chris1seto/OzarkPinnacle/Embedded/OzarkPinnacle/Src/Nmea0183.h

#ifndef NMEA_H
#define NMEA_H

#include <stdint.h>
#include <stm32f4xx_hal.h>
#include "FreeRTOS.h"
#include "task.h"
#include "queue.h"

typedef struct
{
  uint8_t hour;
  uint8_t minute;
  float second;
} NmeaTime_t;

typedef struct
{
  uint8_t day;
  uint8_t month;
  uint8_t year;
} NmeaDate_t;

typedef struct
{
  float lat;
  float lon;
} NmeaPosition_t;

typedef struct
{
  NmeaTime_t time;
  NmeaPosition_t position;
  uint8_t fix;
  int32_t sat_count;
  float h_dop;
  float altitude;
  uint8_t altitude_units;
} NmeaGga_t;

typedef struct
{
  NmeaTime_t time;
  uint8_t fix;
  NmeaPosition_t position;
  float speed;
  float track;
  NmeaDate_t date;
} NmeaRmc_t;

typedef struct
{
  NmeaTime_t time;
  uint8_t day;
  uint8_t month;
  uint32_t year;
  uint8_t valid;
} NmeaZda_t;

enum NMEA_MESSAGE_TYPE
{
  NMEA_MESSAGE_TYPE_GGA,
  NMEA_MESSAGE_TYPE_RMC,
  NMEA_MESSAGE_TYPE_GSA,
  NMEA_MESSAGE_TYPE_ZDA
};

typedef struct
{
  enum NMEA_MESSAGE_TYPE message_type;
  union
  {
    NmeaGga_t gga;
    NmeaRmc_t rmc;
    NmeaZda_t zda;
  };
} GenericNmeaMessage_t;

void Nmea0183_Init(void);
QueueHandle_t* Nmea0183_GetQueue(void);
UART_HandleTypeDef* Nmea0183_GetUartHandle(void);

#endif
