chris1seto/OzarkPinnacle/Embedded/OzarkPinnacle/Src/Watchdog.c

#include <stm32f4xx_hal.h>

static IWDG_HandleTypeDef watchdogHandle;

void WatchdogInit(void)
{
  // Init watchdog
  watchdogHandle.Init.Prescaler = IWDG_PRESCALER_16;
  watchdogHandle.Init.Reload = 0x0fff;
  watchdogHandle.Instance = IWDG;
  HAL_IWDG_Init(&watchdogHandle);
}

void WatchdogFeed(void)
{
  __HAL_IWDG_RELOAD_COUNTER(&watchdogHandle);
}
