chris1seto/OzarkPinnacle/(commit log)

2020-05-26 Added reworked original codebase
    [Afsk.h, AfskDefs.h, AfskEncode.c, Aprs.c, Aprs.h, Audio.c, Ax25.c, Ax25.h]
2020-06-07 Cleanup, added new preamble/filter settings
2020-06-23 Code cleanup, remove lwip, fix memory issue
    [Beacon.c, GpsHub.c, Main.c, Nmea0183.c, Radio.c]
2020-06-23 Added hardware
    [OzarkPinnacle.brd, OzarkPinnacle.sch, OzarkPinnacleBom.csv]
